filippofinke/reaction-time-training/README.md

# Progetto 3
## Partecipanti:
- Bryan Beffa
- Filippo Finke
- Matteo Ghilardini
---
## Direttive:
Realizzazione di un sistema di gioco e simulazione per l'allenamento dei tempi di reazione ed il miglioramento della coordinazione per sportivi basato su Arduino.

---

## Date:
- Inizio: 13/02/2019
- Fine: 22/05/2019
