filippofinke/reaction-time-training/appunti-schema.md

### Configurazione pin dei bottoni:

| Bottone | Pin |
|:---:|----:|
| 0 |  22 |
| 1 |  24 |
| 2 |  26 |
| 3 |  28 |
| 4 |  30 |
| 5 |  32 |
| 6 |  34 |
| 7 |  36 |
| 8 |  38 |
| 9 |  40 |
| # |  42 |
| @ |  44 |

Buzzer1: 6
Buzzer2: 7

Arduino mega:  20 (SDA), 21 (SCL)
