filippofinke/reaction-time-training/pianifica.md

### Da rivedere:

### Da fare:
5. Tiro a vuoto – pulsanti 1 secondo, senior

Comando per uscire da qualsiasi programma.

### In corso

### Fatti da testare
10. Tabelline, test di velocità
99. Errori e problemi fa gestire

### Testati
1. Cumulativo 60 secondi, senior
2. Maratona (5 minuti) senior
3. Corsa 50 pulsanti, senior
4. Stretching angolare, 100 pulsanti, senior
6. Test di Léger o Beep test, senior
7. 50 pulsanti temporizzati, 1 secondo per pulsante, senior
8. Staffetta 4 giocatori (tempo totale 120 secondi), senior
9. Reazione, somma aritmetica
11. Stretching angolare, 25 pulsanti
12. Stretching angolare, 50 pulsanti
13. 25 pulsanti temporizzati, 1 secondo per pulsante, junior
14. 50 pulsanti temporizzati, 1 secondo per pulsante, junior
15. Cumulativo 30 secondi, junior
16. Cumulativo 60 secondi, junior
17. Corsa 25 pulsanti, junior
18. Corsa 50 pulsanti, junior
19. Maratona (3 minuti) junior
20. Semplice gioco Simon: 20 pulsanti, 17 livelli
21. Flash test, 5 schemi
22. Anti- flash test 
23. Reazione veloce, 10 schemi
