filippofinke/reaction-time-training/Presentations/Presentazione.pptx

Batak 2.0

Bryan Beffa, Filippo Finke & Matteo Ghilardini

Notes: Ghila

## Su di noi.

- Bryan Beffa
bryan.beffa@samtrevano.ch
- Filippo Finke
filippo.finke@samtrevano.ch
- Matteo Ghilardini
matteo.ghilardini@samtrevano.ch

Notes: Ghila

## Introduzione.

- Sistema per misurare e migliorare i propri riflessi

Notes: Ghila

## Slide 4

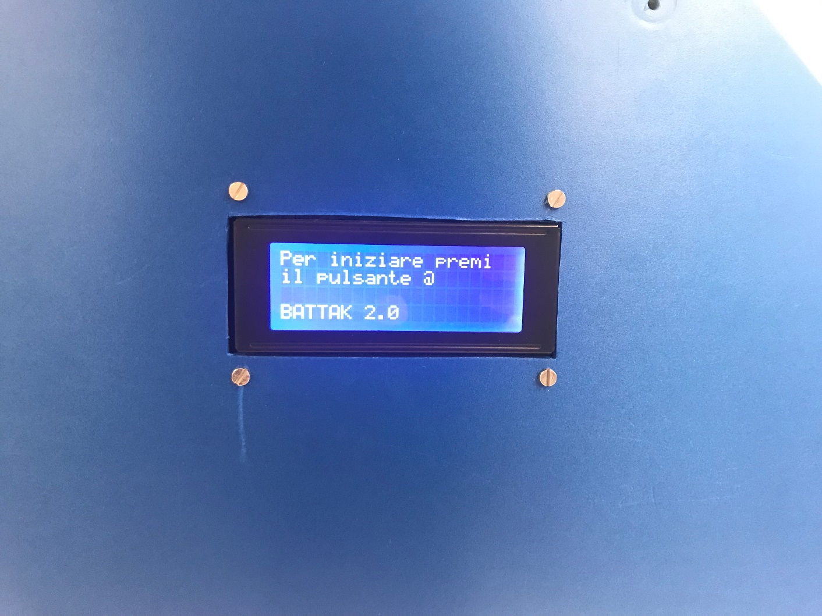
[picture p9: figure]
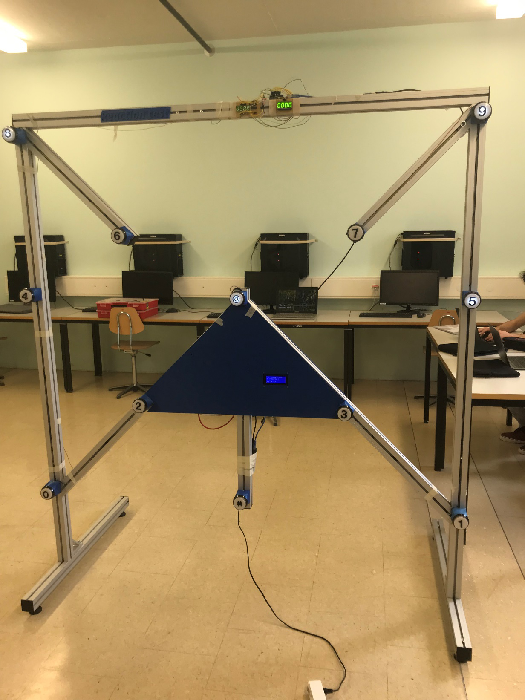
[picture p10: figure]
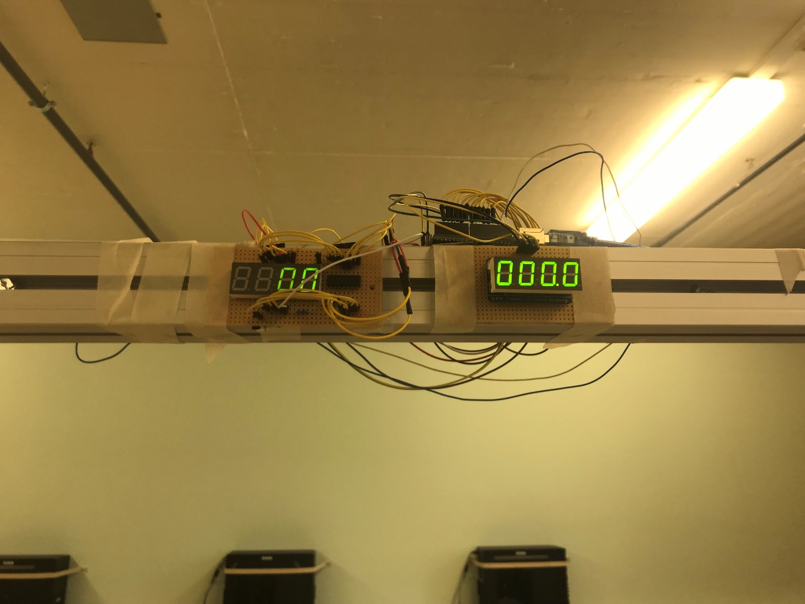
[picture p11: figure]

Notes: Finke

## Scopo.

- Misurare/testare
- Migliorare
- Fare attività fisica

Notes: Bryan:
Misurare: i riflessi di chi prova il nostro sistema
Migliorare i propri riflessi
Aiuta le persone a fare attività fisica. Vedi maratona 5 minuti.

## Requisiti.

Programmi/modalità
Arduino
Procedura di check

Notes: Bryan:
Il nostro sistema doveva/deve avere le varie modalità richieste
Deve essere basato su arduino
Deve avere una procedura di controllo del’hardware

## GANTT preventivo.

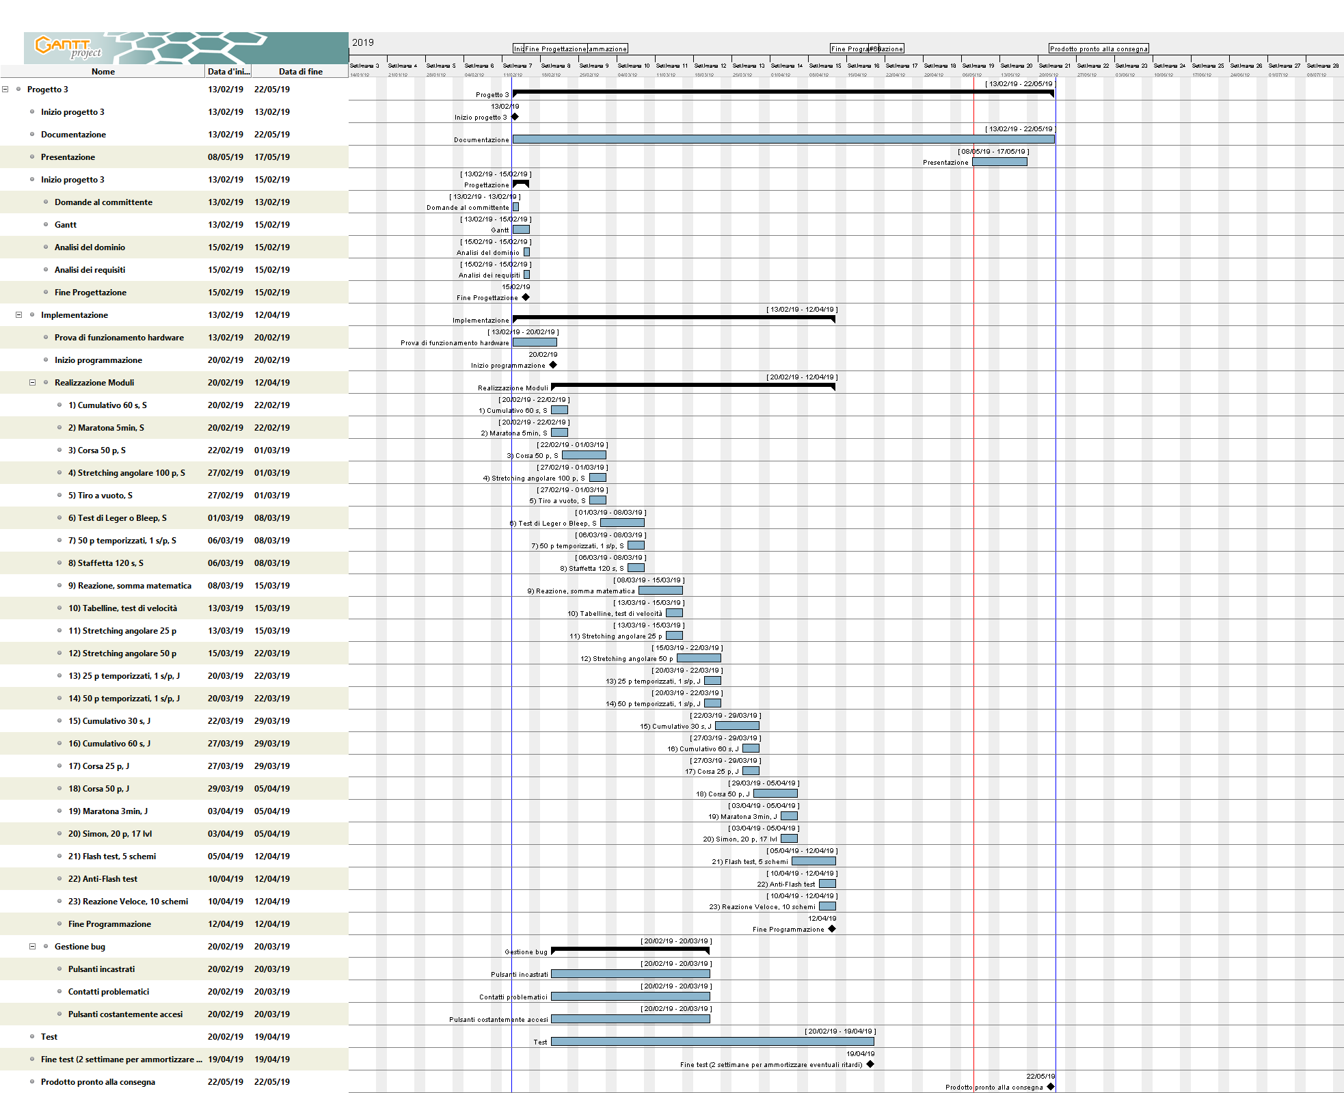
[picture p12: figure]

Notes: Ghila

## Slide 8

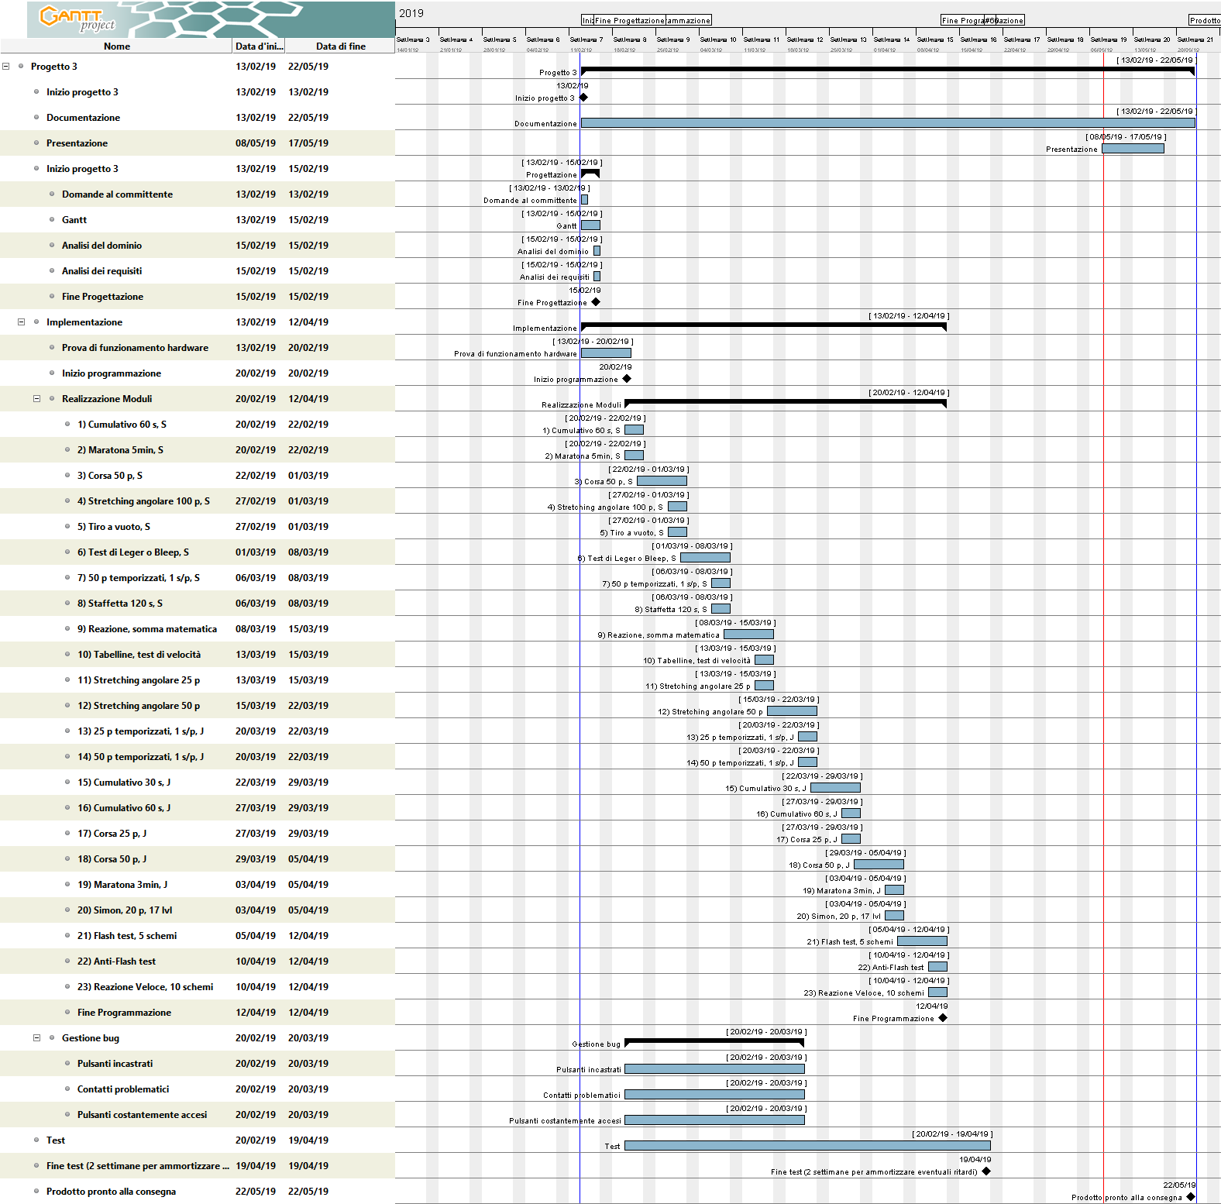
[picture p13: figure]

Notes: Ghila

## Slide 9

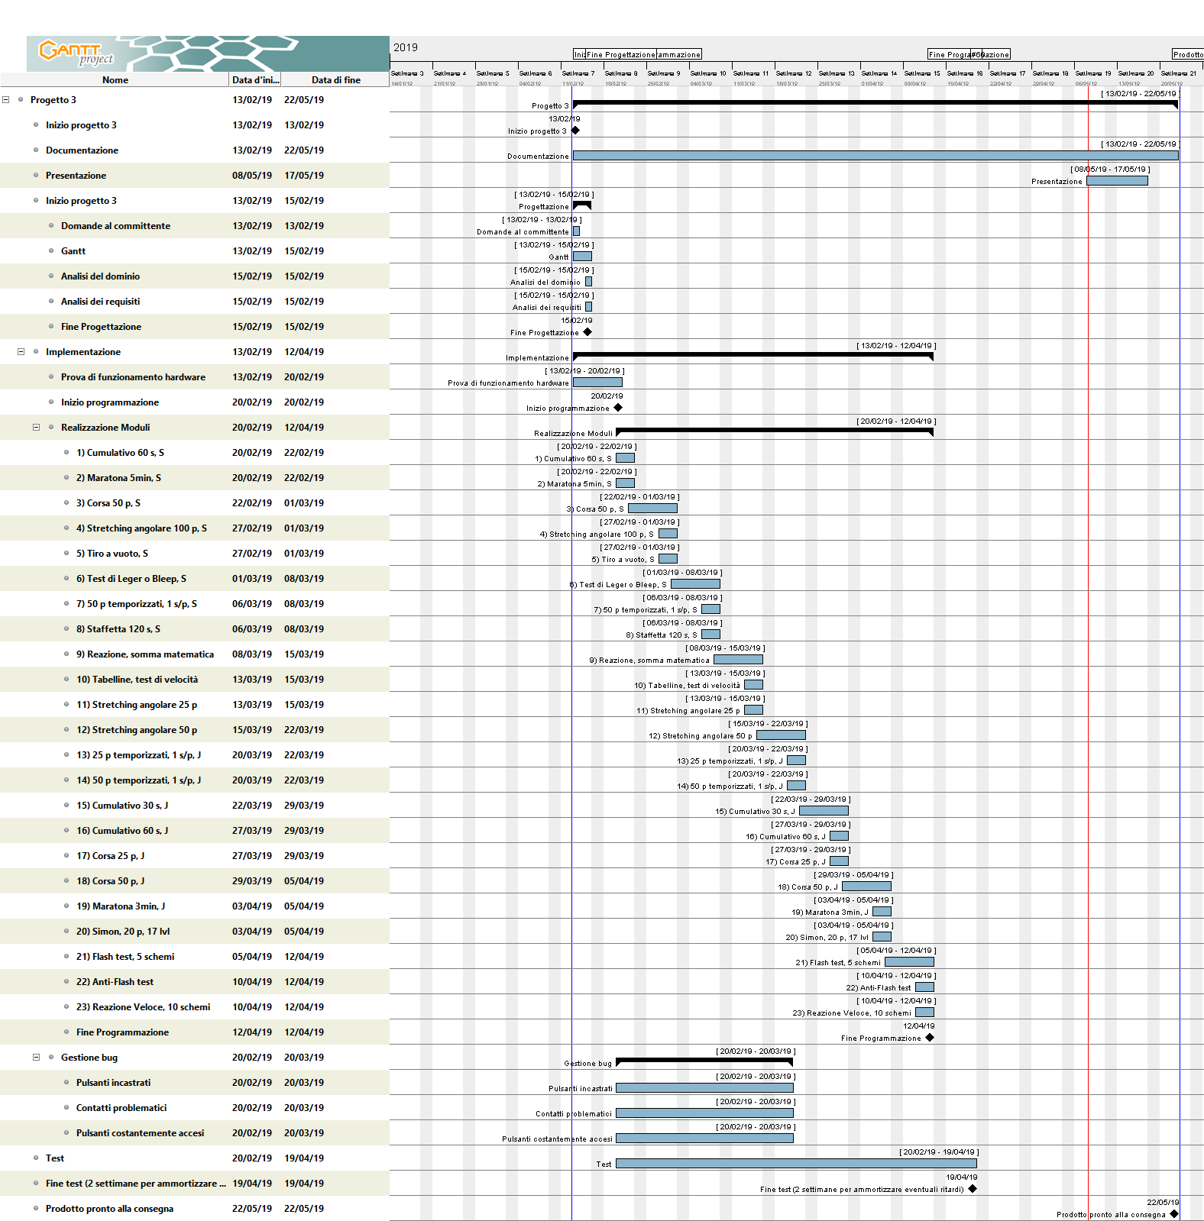
[picture p14: figure]

Notes: Ghila

## GANTT Consuntivo.

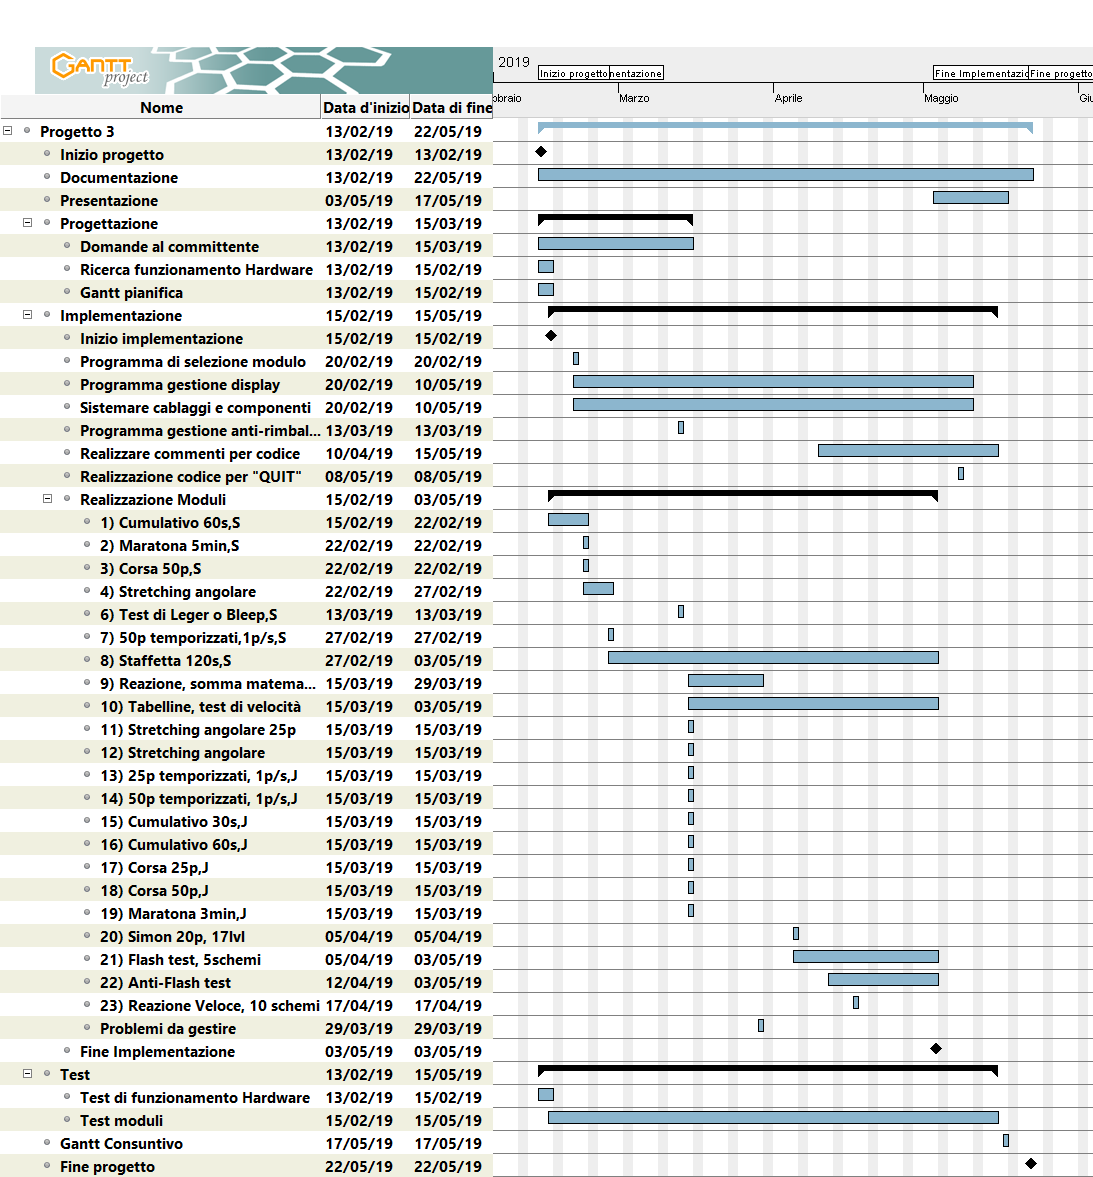
[picture p15: figure]

Notes: Ghila

## Slide 11

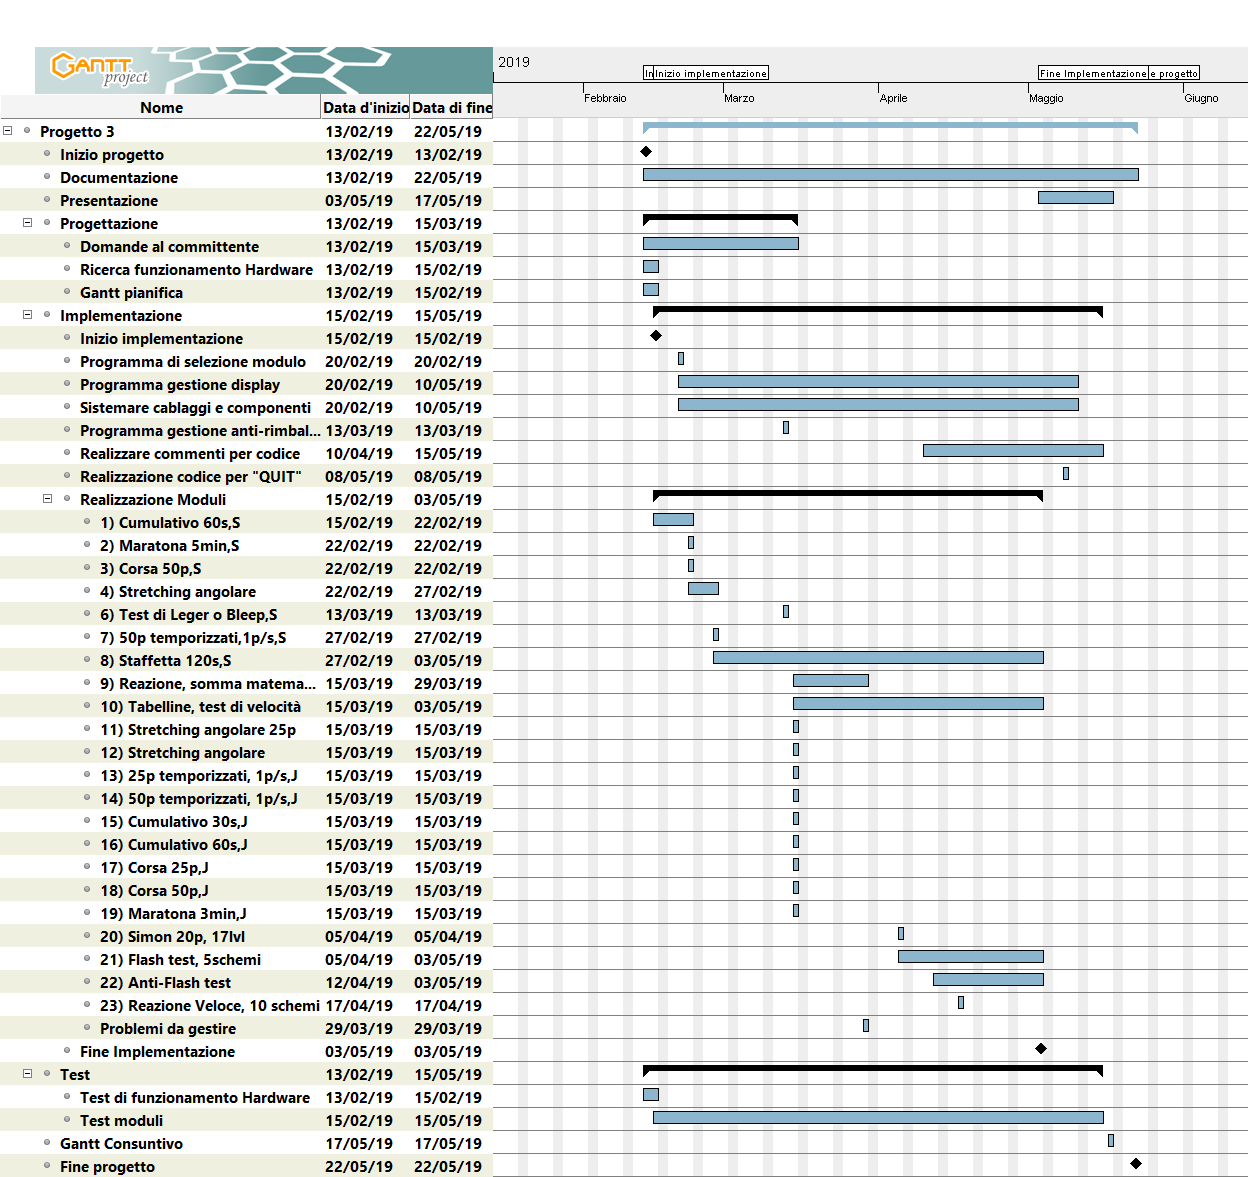
[picture p16: figure]

Notes: Ghila

## Slide 12

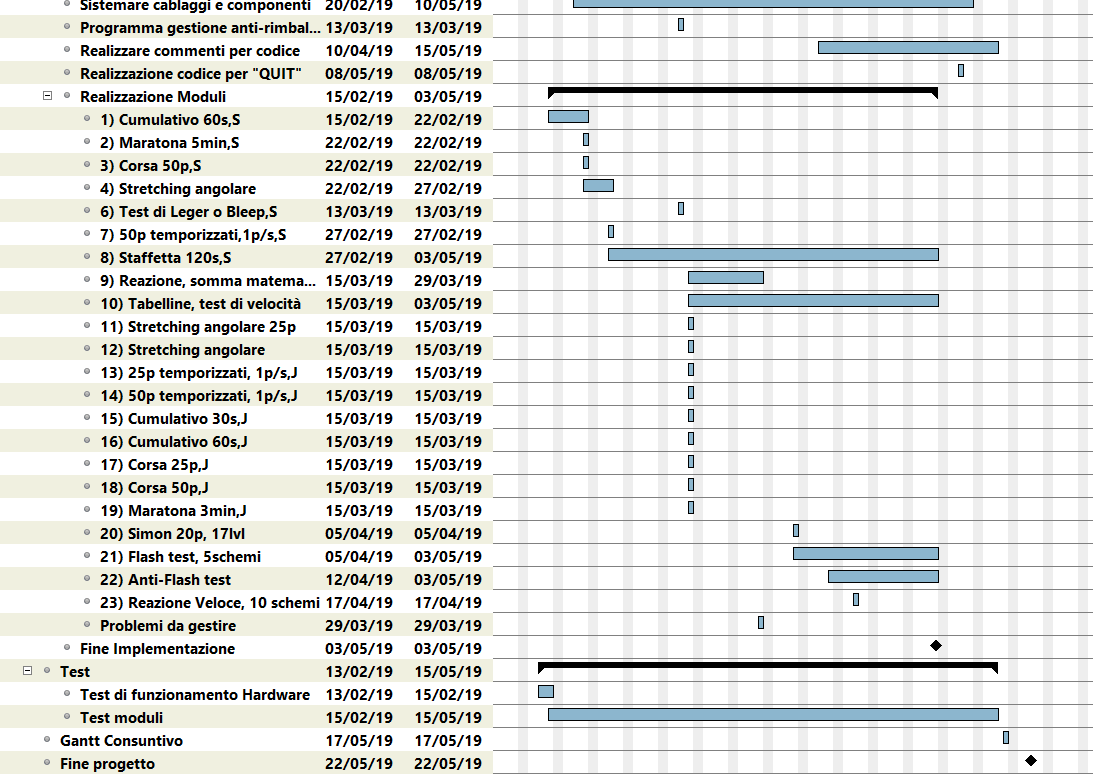
[picture p17: figure]

Notes: Ghila

## Struttura sistema.


Notes: Bryan

## Slide 14

Notes: Bryan:

## Struttura codice.

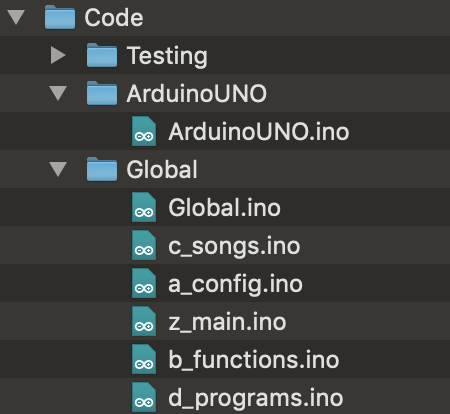
[picture p18: figure]

Notes: finke

## Librerie utilizzate.

- Wire
- LiquidCrystal
- AdaFruit
- SevenSeg

Notes: finke

## File b_functions.

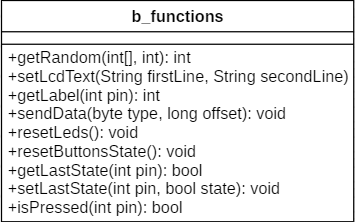
[picture p19: figure]

Notes: finke

## File d_programs.

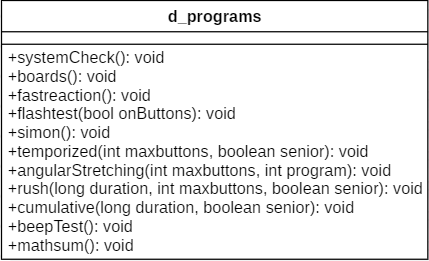
[picture p20: figure]

Notes: finke

## File z_main.

Notes: finke

## Test.

- Test modalità
- Test procedura di check

Notes: Bryan:
Abbiamo effettuato i test su tutti i programmi che sono stati implementati
Abbiamo testato la procedura di controllo del sistema

## Limitazioni.

Programma n° 5
LED
Assistente vocale

Notes: Bryan:
Mancanza del programma numero 5, che richiedeva una pedana/tasto esterno per il funzionamento.
Poca luminosità dei LED
Mancanza assistente vocale nei programmi richiesti

## Sviluppi futuri.

Gestione punteggi
Aggiunta modalità
Hardware

Notes: Bryan:
Gestione punteggi: salvataggio migliori punteggi
Aggiunta di nuove modalità: ad esempio modalità n° 5
Migliorare l’hardware

## Conclusioni.

Notes: Ghila
