filippofinke/reaction-time-training/Documentation/img/b_functions.png

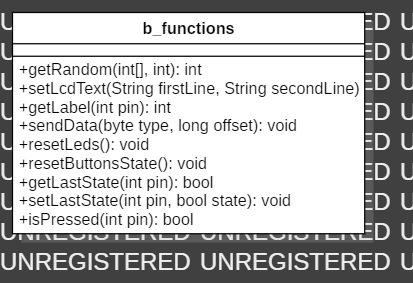
Documentation/img/b_functions.png
