filippofinke/reaction-time-training/Documentation/img/barriera_luminosa.jpg

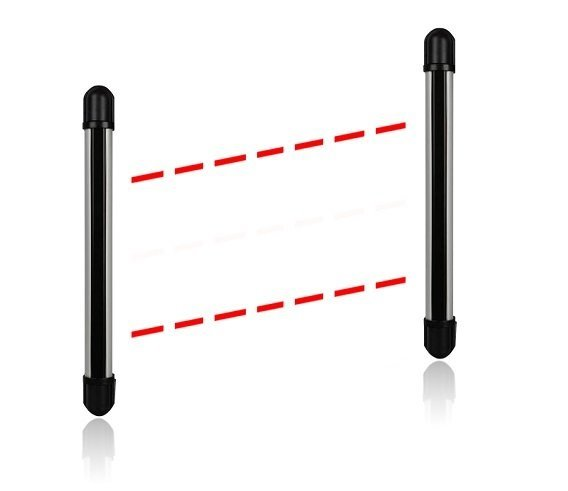
Documentation/img/barriera_luminosa.jpg
