filippofinke/reaction-time-training/Documentation/img/d_programs.png

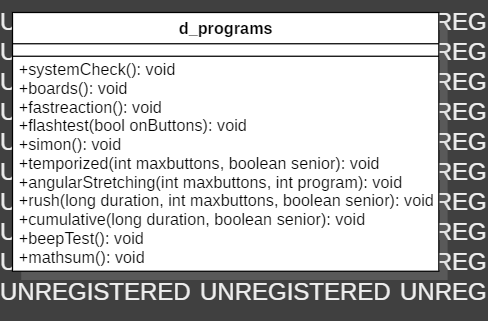
Documentation/img/d_programs.png
