filippofinke/reaction-time-training/Documentation/img/pedana-sollevamento.jpg

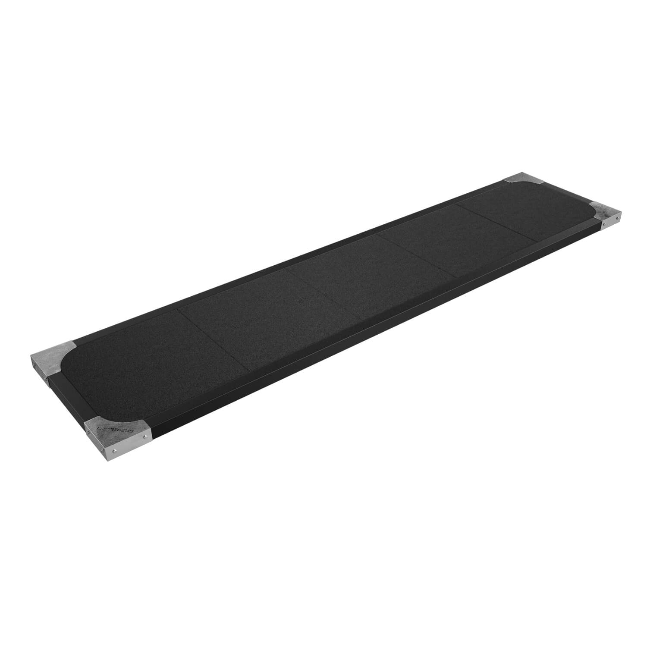
Documentation/img/pedana-sollevamento.jpg
