filippofinke/reaction-time-training/Documentation/img/z_main.png

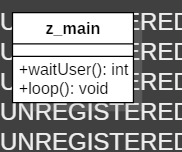
Documentation/img/z_main.png
