filippofinke/reaction-time-training/Gantt Charts/Gantt_Pianificazione.png

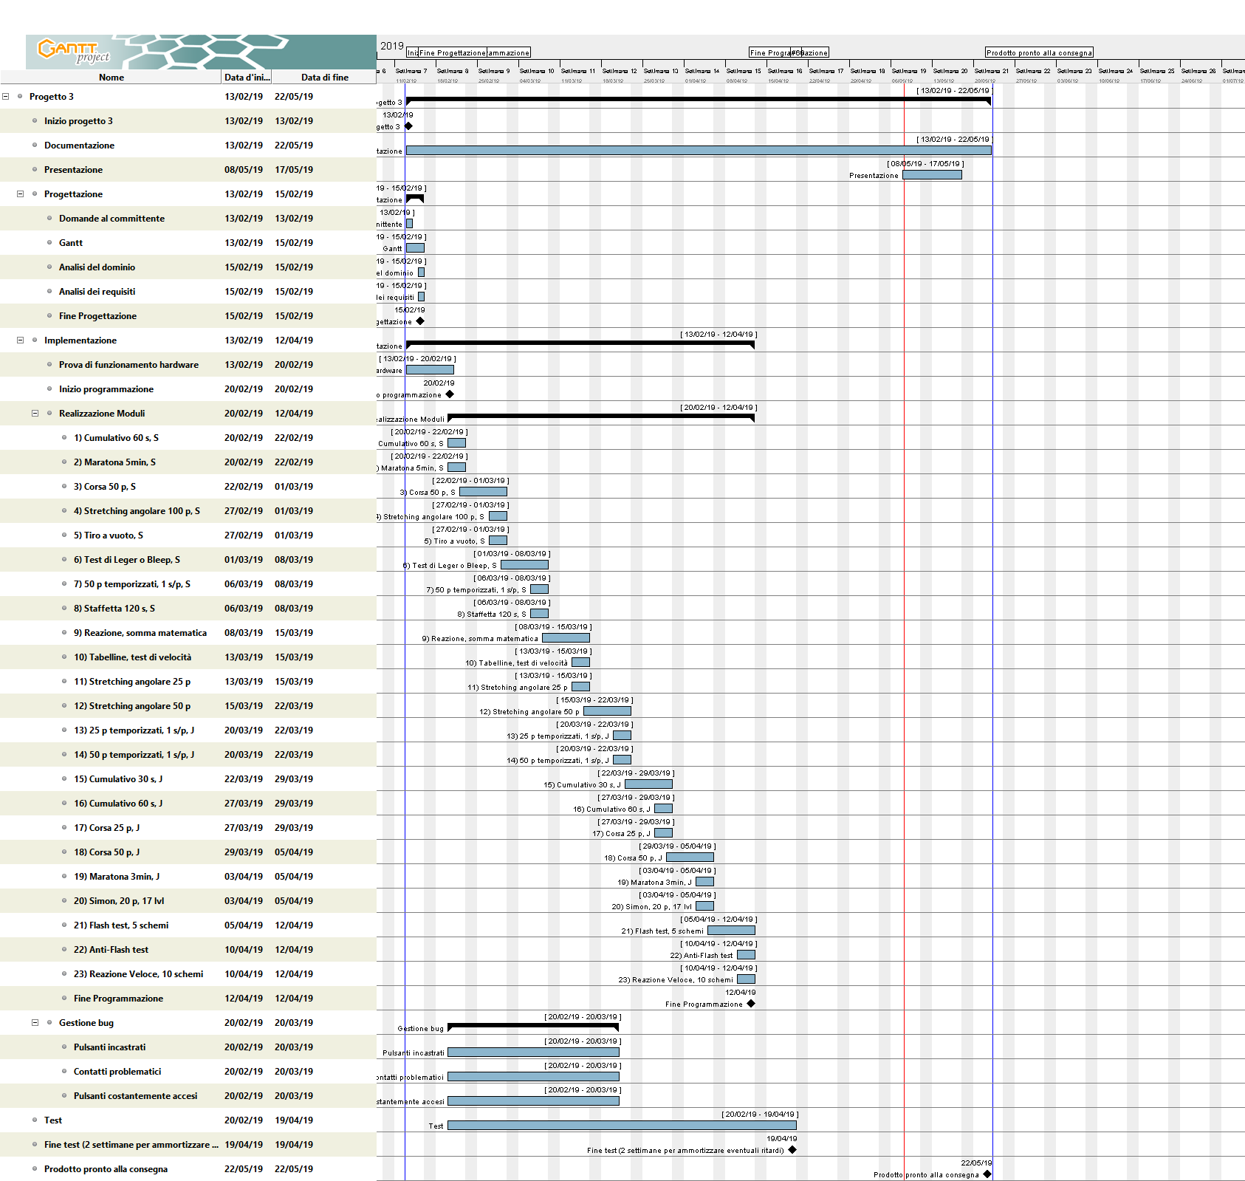
Gantt Charts/Gantt_Pianificazione.png
