filippofinke/reaction-time-training/Documentation/2019.03.22_beffa_finke_ghilardini_procedura_check_manual.docx

# Procedura di check

# Procedura di check

Per controllare che il sistema sia funzionante è stata progettata una procedura di check. È una procedura utilizzata per verificare che il sistema non rilevi errori.

Per avviare la funzione di check bisogna eseguire i seguenti passi:

1. Accendere il sistema e aspettare che sia pronto
2. Premere il pulsante “@”
3. Successivamente selezionare “99”
4. Attendere che il sistema finisca il check del sistema

B. Beffa, F. Finke, M. Ghilardini I3AA 22.03.2019
