filippofinke/reaction-time-training/Work Diaries/md/2019.02.13_i3_beffa_finke_ghilardini_diario_prog3.md

# Progetto 3 | Diario di lavoro
##### B. Beffa, F. FInke, M. Ghilardini
### Trevano, 2019-02-13
---
## Lavori svolti
- Abbiamo ricevuto il QDC;
- Abbiamo realizzato le domande per il committente;
- Iniziato a raccogliere le informazioni per il progetto (documentazione dell’hardware, …);
<br>
Sulla base di questa abbiamo cominciato ad eseguire dei test sul funzionamento del circuito;
    - Testato il funzionamento led e bottoni del telaio;
    - Mappato i pin dei bottoni con il relativo nome;
- Abbiamo realizzato una prima bozza della pianificazione;
- Cominciato la realizzazione della documentazione impostando i requisiti;

---

## Problemi riscontrati e soluzioni adottate 
Nessun problema.

---

##  Punto della situazione rispetto alla pianificazione
(Non ancora svolta definitivamente, ma per quanto riguarda la bozza: In linea)

---

## Programma di massima per la prossima giornata di lavoro
- Aggiunta dei requisiti alla documentazione;
- Completare il capitolo di analisi;
