filippofinke/reaction-time-training/Work Diaries/provvisori/2019.04.12_i3_beffa_finke_ghilardini_diario_prog3.docx

# Diario di lavoro

Luogo | Trevano
Data | 2019-04-12

Lavori svolti

Abbiamo:

- Realizzato il programma 22 (Anti-Flash test);
- Proseguito con la realizzazione della doc realizzando il primo sotto capitolo del capitolo Implementazione;
- Sistemato nuovamente piccoli dettagli nella doc;
- Iniziato l’inserimento dei commenti nel codice;

Problemi riscontrati e soluzioni adottate

Punto della situazione rispetto alla pianificazione

Programmi in corso:

- Stretching angolare, 25 (e 50) pulsanti: dobbiamo sistemare i display 7 segmenti;

Programmi da revisionare:

- Tabelline, test di velocità;
- Tiro a vuoto – pulsanti 1 secondo, senior;

Programmi ancora da fare:

- Reazione veloce, 10 schemi;

Nelle tempistiche ma non rispettando il programma riportato nel Gantt.

Programma di massima per la prossima giornata di lavoro

Proseguire con i programmi mancanti.

Proseguire la stesura del capitolo “Implementazione”.

Sistema di gioco e simulazione per l’allenamento dei tempi di reazione ed il miglioramento della coordinazione per sportivi basato su Arduino.

B. Beffa, F. Finke, M. GhilardiniI3Progetto 3
