filippofinke/reaction-time-training/Work Diaries/provvisori/2019.04.10_i3_beffa_finke_ghilardini_diario_prog3.docx

# Diario di lavoro

Luogo | Trevano
Data | 2019-04-10

Lavori svolti

Abbiamo:

- Realizzato tutti i diari di lavoro quotidiani in formato md;
- Avviato la stesura del capitolo “Implementazione”;
- Aggiunto commenti al codice;
- Revisionato la doc modificando la struttura;

Problemi riscontrati e soluzioni adottate

Punto della situazione rispetto alla pianificazione

Programmi in corso:

- Stretching angolare, 25 (e 50) pulsanti: dobbiamo sistemare i display 7 segmenti;

Programmi da revisionare:

- Tabelline, test di velocità;
- Tiro a vuoto – pulsanti 1 secondo, senior;

Programmi ancora da fare:

- Anti-flash test;
- Reazione veloce, 10 schemi;

Nelle tempistiche ma non rispettando il programma riportato nel Gantt.

Programma di massima per la prossima giornata di lavoro

Proseguire con i programmi mancanti.

Sistema di gioco e simulazione per l’allenamento dei tempi di reazione ed il miglioramento della coordinazione per sportivi basato su Arduino.

B. Beffa, F. Finke, M. GhilardiniI3Progetto 3
