filippofinke/reaction-time-training/Work Diaries/provvisori/2019.04.03_i3_beffa_finke_ghilardini_diario_prog3.docx

# Diario di lavoro

Luogo | Trevano
Data | 2019-04-03

Lavori svolti

Abbiamo deciso di utilizzare la lezione di oggi per eseguire un resoconto del lavoro svolto fino ad oggi. In sostanza abbiamo revisionato ciò che abbiamo scritto fino ad ora nella documentazione ed eseguito i test di ogni programma svolto fino ad oggi.

Problemi riscontrati e soluzioni adottate

Punto della situazione rispetto alla pianificazione

Programmi in corso:

- Stretching angolare, 25 (e 50) pulsanti: dobbiamo sistemare i display 7 segmenti;

Programmi da revisionare:

- Tabelline, test di velocità;
- Tiro a vuoto – pulsanti 1 secondo, senior;

Programmi ancora da fare:

- Semplice gioco Simon: 20 pulsanti, 17 livelli;
- Flash test, 5 schemi;
- Anti-flash test;
- Reazione veloce, 10 schemi;

Globalmente in linea.

Programma di massima per la prossima giornata di lavoro

Proseguire con i programmi mancanti

Sistema di gioco e simulazione per l’allenamento dei tempi di reazione ed il miglioramento della coordinazione per sportivi basato su Arduino.

B. Beffa, F. Finke, M. GhilardiniI3Progetto 3
