filippofinke/reaction-time-training/Work Diaries/provvisori/2019.03.13_i3_beffa_finke_ghilardini_diario_prog3.docx

# Diario di lavoro

Luogo | Trevano
Data | 2019-03-13

Lavori svolti

Abbiamo:

- Preparato il cavo per collegare l’Arduino principale con quello che gestisce i 2 display;
- Risolto il problema relativo all’anti-rimbalzo;
- Rilevati i pin da utilizzare per i Buzzer;
- Implementati programma 6;
- Risolti vari problemi in altri programmi;

Problemi riscontrati e soluzioni adottate

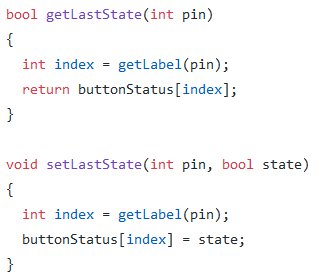
[picture p28: figure]

- Codice che gestisce l’anti-rimbalzo:

Punto della situazione rispetto alla pianificazione

In ritardo (non avevamo preso in considerazione la pausa dovuta alle vacanze scolastiche).

Programma di massima per la prossima giornata di lavoro

Completare programmi fino all’11 e cominciare il 12

Fissare il display 7 segmenti sul telaio

Riflettere sull’implementazione del display LCD

Sistema di gioco e simulazione per l’allenamento dei tempi di reazione ed il miglioramento della coordinazione per sportivi basato su Arduino.

B. Beffa, F. Finke, M. GhilardiniI3Progetto 3
