filippofinke/reaction-time-training/Work Diaries/2019.02.22_i3_beffa_finke_ghilardini_diario_prog3.pdf

B. Beffa, F. Finke, M. Ghilardini | I3 | Progetto 3

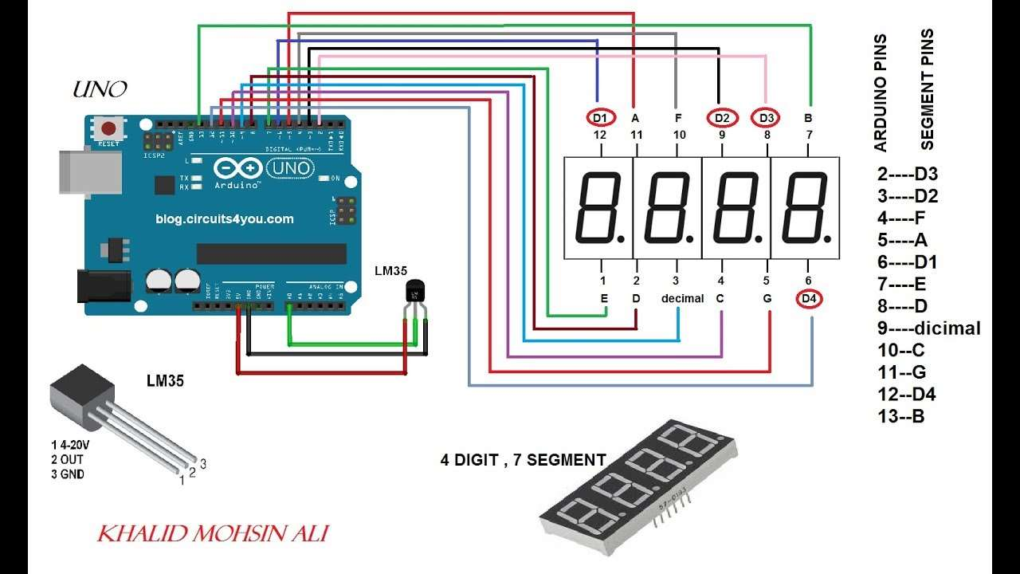
[picture p29: figure]

Sistema di gioco e simulazione per l’allenamento dei tempi di reazione ed il miglioramento della coordinazione per sportivi basato su Arduino.

# Diario di lavoro

Luogo | Trevano
Data | 2019-02-22

Lavori svolti
- Abbiamo:
o Sistemato parzialmente la questione del display 7 segmenti che non funzionava correttamente.
Per fare questo, oltre a ricercare il problema, e agire di conseguenza, abbiamo dovuto dissaldare e poi saldare nuovamente un pin del display;
o I 2 display sono stati collegati fra loro;
o Risolto problema di conversione da stringa ad intero utilizzando la funzione atol() https://forum.arduino.cc/index.php?topic=475803.0;
o Risolto problema parametri di tipo long passando da: cumulative(60 * 1000, false), a cumulative (60000, false);
o Modificato il tipo di ritorno della funzione principale per la seleziona delle modalità di gioco da stringa ad intero;
o Implementato definitivamente programmi 1, 2 e 3;
o Iniziata l’implementazione del programma 4;

Problemi riscontrati e soluzioni adottate
- Il secondo display (quello fissato direttamente su una veroboard e che nella lezione precedente abbiamo dato per rotto e quindi chiesto una sostituzione) non accende tutti i segmenti che dovrebbe, ma rispetto alla lezione precedente, ci siamo resi conto che probabilmente il problema è legato ai cablaggi, per controllare abbiamo utilizzato:

https://i.ytimg.com/vi/utsQWM_FVQg/maxresdefault.jpg ;
o Ci siamo accorti che 1 pin del display non era saldato correttamente, quindi l’abbiamo risaldato;

B. Beffa, F. Finke, M. Ghilardini | I3 | Progetto 3

Sistema di gioco e simulazione per l’allenamento dei tempi di reazione ed il miglioramento della coordinazione per sportivi basato su Arduino.

o Per semplificare la stesura del codice abbiamo deciso di utilizzare una libreria (https://github.com/sparkfun/SevSeg) .
o Altri link che abbiamo utilizzato per raggiungere la soluzione:
- https://create.arduino.cc/projecthub/essoselectronic/sevseg-library-on-4-digitanode-segment-ae7eed;
- https://www.hackster.io/SAnwandter1/programming-4-digit-7-segment-leddisplay-2d33f8;
- https://www.electronics-tutorials.ws/blog/7-segment-display-tutorial.html; o Alcuni valori del display vengono ancora rappresentati in maniera errata;

Punto della situazione rispetto alla pianificazione In anticipo

Programma di massima per la prossima giornata di lavoro Risolvere problema del display.
Proseguire l’implementazione del programma 4 Iniziare implementazione programma 5
