filippofinke/reaction-time-training/Work Diaries/md/2019.02.27_i3_beffa_finke_ghilardini_diario_prog3.md

# Progetto 3 | Diario di lavoro
##### B. Beffa, F. FInke, M. Ghilardini
### Trevano, 2019-02-27
---
## Lavori svolti
- Ci è stato consegnato il display 7 segmenti che avevamo chiesto qualche settimana fa;
- Abbiamo:
    - Implementato i programmi 4, 7 e 8 (5 e 6 posticipati a causa della necessità del cicalino);
    - Realizzato i primi 8 test case;

---

## Problemi riscontrati e soluzioni adottate 
| Problema | Soluzione adottata | 
|---|---|
|Display 7 segmenti non funzionante. | Lo abbiamo sostituito e testato, rimane solo da montarlo sul telaio.|
| Non abbiamo implementato nessun sistema anti-rimbalzo per i pulsanti. | Dovremo pensare a implementarlo al più presto.

---

##  Punto della situazione rispetto alla pianificazione
In anticipo

---

## Programma di massima per la prossima giornata di lavoro
- Completare programmi 5 e 6;
- Installare il display 7 segmenti sul telaio;
