filippofinke/reaction-time-training/Work Diaries/md/2019.03.01_i3_beffa_finke_ghilardini_diario_prog3.md

# Progetto 3 | Diario di lavoro
##### B. Beffa, F. FInke, M. Ghilardini
### Trevano, 2019-03-01
---
## Lavori svolti
Dal momento che entrambi i miei compagni di gruppo (Beffa e Finke), oggi erano asenti, ho approfittato di queste ore per effettuare una revisione generale del lavoro svolto nel corso delle lezioni svolte e sistemare:
- Capitolo 1.6 della documentazione realizzando una versione più compatta e indicativa del Gantt per poterlo rendere più grande e quindi più leggibile;
- Sempre in merito al capitolo 1.6, ho anche realizzato il commento relativo al suddetto Gantt;
- Aggiunto altri requisiti;

---

## Problemi riscontrati e soluzioni adottate 
| Problema | Soluzione adottata | 
|---|---|
| Non abbiamo implementato nessun sistema anti-rimbalzo per i pulsanti. | Dovremo pensare a implementarlo al più presto.

---

##  Punto della situazione rispetto alla pianificazione
In anticipo di circa 1 settimana

---

## Programma di massima per la prossima giornata di lavoro
- Completare programmi 5 e 6;
- Installare il display 7 segmenti;
