filippofinke/reaction-time-training/Work Diaries/md/2019.03.15_i3_beffa_finke_ghilardini_diario_prog3.md

# Progetto 3 | Diario di lavoro
##### B. Beffa, F. FInke, M. Ghilardini
### Trevano, 2019-03-15
---
## Lavori svolti
Oggi abbiamo:
- Aggiunto i programmi dal 9 al 19;
- Revisionato alcuni dei programmi realizzati in precedenza per aggiungere dinamicità nella stesura del codice;
- Discusso dei programmi “Tabelline, test di velocità” e “Tiro a vuoto – pulsanti 1 secondo, senior”, il problema consiste nel fatto di dover fare un suono audio e non di frequenza e che di conseguenza con il buzzer non possiamo farlo. Ci è stato detto di lasciarli da parte per il momento;
- Proseguito i protocolli di test dal 12 al 20;
- Completato la stesura dei requisiti (realizzati 20, 21, 22, 23, 24);
- Revisionato e corretto la doc;

---

## Problemi riscontrati e soluzioni adottate 
| Problema | Soluzione adottata | 
|---|---|
|Con il buzzer possiamo solo esprimere delle frequenze e non del testo.|Su direttiva del committente, lasciamo perdere per il momento. 

---

##  Punto della situazione rispetto alla pianificazione
Recuperato il ritardo della lezione scorsa arrivando ad essere in anticipo sulla pianificazione.

---

## Programma di massima per la prossima giornata di lavoro
- <b>Test di Léger o Beep test, senior</b><br>
Mancanza: Implementare il display LCD.
- <b>Reazione, somma aritmetica</b><br>
Mancanza: Display LCD.
- <b>Stretching angolare, 25 pulsanti</b><br>
Mancanza: Fix display 7 segmenti (la virgola).
- <b>Stretching angolare, 50 pulsanti</b><br>
Mancanza: Fix display 7 segmenti (la virgola).
