filippofinke/reaction-time-training/Work Diaries/md/2019.04.05_i3_beffa_finke_ghilardini_diario_prog3.md

# Progetto 3 | Diario di lavoro
##### B. Beffa, F. FInke, M. Ghilardini
### Trevano, 2019-04-05
---
## Lavori svolti
Abbiamo completato i programmi:
- Semplice gioco di Simon: 20 pulsanti, 17 livelli;
- Flash test, 5 schemi;

---

## Problemi riscontrati e soluzioni adottate 
| Problema | Soluzione adottata | 
|---|---|
|

---

##  Punto della situazione rispetto alla pianificazione

Globalmente in linea.

- Programmi in corso:
    - <b>Stretching angolare, 25 (e 50) pulsanti: </b><br>dobbiamo sistemare i display 7 segmenti;
- Programmi da revisionare:
    - Tabelline, test di velocità;
    - Tiro a vuoto - pulsanti 1 secondo, senior;
- Programmi ancora da fare:
    - Anti-flash test;
    - Reazione veloce, 10 schemi;

---

## Programma di massima per la prossima giornata di lavoro
- Proseguire con i programmi mancanti.
