filippofinke/reaction-time-training/Work Diaries/md/2019.02.15_i3_beffa_finke_ghilardini_diario_prog3.md

# Progetto 3 | Diario di lavoro
##### B. Beffa, F. FInke, M. Ghilardini
### Trevano, 2019-02-15
---
## Lavori svolti
- Finke ha dovuto svolgere la presentazione del Progetto 2;
- Abbiamo:
    - Completato il diagramma Gantt;
    - Proseguito nella parte di analisi dei requisiti;
    - Completato l'analisi del dominio;
    - Completato il capitolo "Scopo";
    - Realizzato un codice per testare il funzionamento del display 7 segmenti
    - Iniziato a realizzare il codice per il primo modulo;

---

## Problemi riscontrati e soluzioni adottate 
| Problema | Soluzione adottata | 
|---|---|
|Il 7 segmenti che dovrebbe indicare il tempo, non funziona. | Ci siamo accorti che il problema era nei contatti del display, quindi la soluzione che abbiamo adottato è stata quella di raddrizzarli e inserirli in modo corretto nei vari pin. |
| La luminosità dei vari pulsanti era troppo bassa. | Avevamo dimenticato di impostare il pimode().

---

##  Punto della situazione rispetto alla pianificazione
Leggermente in anticipo.

---

## Programma di massima per la prossima giornata di lavoro
- Completare la fase per il check del funzionamento dell’hardware;
- Proseguire il modulo 1 (Cumulativo 60 [s], Senior) e iniziare il successivo;
