filippofinke/reaction-time-training/Work Diaries/provvisori/2019.05.22_i3_beffa_finke_ghilardini_diario_prog3.docx

# Diario di lavoro

Luogo | Trevano
Data | 2019-05-22

Lavori svolti

Oggi abbiamo:

- Completato la documentazione;
- Sistemato il pulsante “#” che si incastrava molto spesso;
- Fissato al telaio il pulsante “1” che dall’inizio del progetto era fissato solo con del nastro adesivo;
- Unito i diari per la stampa;
- Stampato sia i diari, sia la documentazione;
- Rilegato il fascicolo;
- Consegnato il progetto;

Problemi riscontrati e soluzioni adottate

Punto della situazione rispetto alla pianificazione

Progetto completato entro la data designata

Programma di massima per la prossima giornata di lavoro

Sistema di gioco e simulazione per l’allenamento dei tempi di reazione ed il miglioramento della coordinazione per sportivi basato su Arduino.

B. Beffa, F. Finke, M. GhilardiniI3Progetto 3
