filippofinke/reaction-time-training/Work Diaries/provvisori/2019.05.17_i3_beffa_finke_ghilardini_diario_prog3.docx

# Diario di lavoro

Luogo | Trevano
Data | 2019-05-17

Lavori svolti

Oggi abbiamo:

- Realizzato il Gantt consuntivo;
- Completato i sotto-capitoli dell’implementazione 20 e 22;
- Terminato la presentazione;
- Aggiunto il consuntivo alla doc (manca il commento);
- Sistemato il layout della maggior parte dei codici del capitolo implementazione;
- Aggiunta la sitografia alla doc;

Problemi riscontrati e soluzioni adottate

Punto della situazione rispetto alla pianificazione

Nelle tempistiche

Programma di massima per la prossima giornata di lavoro

Completare il capitolo 21 e il 23 dell’implementazione

Revisione globale del lavoro prima di consegnarlo

Sistema di gioco e simulazione per l’allenamento dei tempi di reazione ed il miglioramento della coordinazione per sportivi basato su Arduino.

B. Beffa, F. Finke, M. GhilardiniI3Progetto 3
