filippofinke/reaction-time-training/Work Diaries/provvisori/2019.05.15_i3_beffa_finke_ghilardini_diario_prog3.docx

# Diario di lavoro

Luogo | Trevano
Data | 2019-05-15

Lavori svolti

Oggi abbiamo proseguito il capitolo “Implementazione” (i sotto-capitoli fino al 20 e il 22 e il 24 sono completati) e realizzato nuovi commenti per il codice sistemando anche nuovi piccoli errori sorti dall’analisi più approfondita del codice.

Problemi riscontrati e soluzioni adottate

Punto della situazione rispetto alla pianificazione

Non escludiamo la possibilità di terminare il lavoro in anticipo di qualche ora.

Programma di massima per la prossima giornata di lavoro

Terminare la stesura del capitolo “Implementazione” e realizzare il gantt consuntivo in modo da inserirlo e completare così la presentazione.

Sistema di gioco e simulazione per l’allenamento dei tempi di reazione ed il miglioramento della coordinazione per sportivi basato su Arduino.

B. Beffa, F. Finke, M. GhilardiniI3Progetto 3
