filippofinke/reaction-time-training/Work Diaries/provvisori/2019.04.17_i3_beffa_finke_ghilardini_diario_prog3.docx

# Diario di lavoro

Luogo | Trevano
Data | 2019-04-17

Lavori svolti

Abbiamo:

- Riempito la tabella dei test nella documentazione, notando che alcuni programmi presentavano qualche imperfezione da sistemare;
- Implementato il programma 23 e sistemati altri;
- Proseguito il capitolo “Implementazione” della doc;
- Proseguito l’inserimento dei commenti nel codice;
- Inserito il requisito 5 nella doc perché lo avevamo lasciato indietro a causa dell’impossibile realizzazione di esso;

Per realizzare il programma 10, ci serve un amplificatore per poter “dire” le tabelline che poi il giocatore dovrà risolvere. Dobbiamo procurarcene uno il prima possibile. Abbiamo trovato questo:

https://www.sparkfun.com/products/12660

Problemi riscontrati e soluzioni adottate

Punto della situazione rispetto alla pianificazione

Nelle tempistiche ma non rispettando il programma riportato nel Gantt.

Programma di massima per la prossima giornata di lavoro

Sistemare i programmi mancanti.

Proseguire la stesura del capitolo “Implementazione”.

Sistema di gioco e simulazione per l’allenamento dei tempi di reazione ed il miglioramento della coordinazione per sportivi basato su Arduino.

B. Beffa, F. Finke, M. GhilardiniI3Progetto 3
