filippofinke/reaction-time-training/Work Diaries/provvisori/2019.02.27_i3_beffa_finke_ghilardini_diario_prog3.docx

# Diario di lavoro

Luogo | Trevano
Data | 2019-02-27

Lavori svolti

- Ci è stato consegnato il display 7 segmenti che avevamo chiesto qualche settimana fa
- Abbiamo:
  - Implementati programmi 4, 7 e 8 (5 e 6 posticipati a causa della necessità del cicalino);
  - Realizzato i primi 8 test case;

Problemi riscontrati e soluzioni adottate

- Avendo ricevuto il nuovo 7 segmenti, abbiamo risolto tutti i problemi legati ad esso, ci rimane solo da installarlo sul telaio.
- Non c’è l’anti-rimbalzo sui pulsanti, dovremo implementarlo al più presto.

Punto della situazione rispetto alla pianificazione

In anticipo

Programma di massima per la prossima giornata di lavoro

Completare programmi 5 e 6

Installare il display 7 segmenti sul telaio

Sistema di gioco e simulazione per l’allenamento dei tempi di reazione ed il miglioramento della coordinazione per sportivi basato su Arduino.

B. Beffa, F. Finke, M. GhilardiniI3Progetto 3
