filippofinke/reaction-time-training/Work Diaries/provvisori/2019.02.15_i3_beffa_finke_ghilardini_diario_prog3.docx

# Diario di lavoro

Luogo | Trevano
Data | 2019-02-15

Lavori svolti

- Finke ha dovuto svolgere la presentazione del progetto 2;
- Abbiamo:
  - Completato il diagramma Gantt;
  - Proseguito con la parte di analisi dei requisiti;
  - Completato l’analisi del dominio;
  - Completato lo scopo;
  - Realizzato un codice per verificare il funzionamento del display sette-segmenti;
  - Iniziato a realizzare il codice per il primo modulo;

Problemi riscontrati e soluzioni adottate

- Il sette-segmenti che dovrebbe indicare il tempo non funzionava;
  - Ci siamo accorti che il problema era nei contatti del display, quindi la soluzione che abbiamo adottato è stata quella di raddrizzarli e inserirli in modo corretto nei vari pin.
- La luminosità dei vari pulsanti era troppo bassa;
  - Avevamo dimenticato di impostare il pinmode;

Punto della situazione rispetto alla pianificazione

Leggermente in anticipo

Programma di massima per la prossima giornata di lavoro

Completare la fase per il check del funzionamento dell’hardware

Proseguire il modulo 1 (Cumulativo 60 [s], Senior) e iniziare il successivo

Sistema di gioco e simulazione per l’allenamento dei tempi di reazione ed il miglioramento della coordinazione per sportivi basato su Arduino.

B. Beffa, F. Finke, M. GhilardiniI3Progetto 3
