filippofinke/reaction-time-training/Code/Global/Global.ino

/*
   Gloabl
   File il quale da il nome al progetto Arduino da parte dell'IDE.

   @author Filippo Finke

      LABEL    PIN

   |    0    |  22 |
   |    1    |  24 |
   |    2    |  26 |
   |    3    |  28 |
   |    4    |  30 |
   |    5    |  32 |
   |    6    |  34 |
   |    7    |  36 |
   |    8    |  38 |
   |    9    |  40 |
   |    #    |  42 |
   |    @    |  44 |
*/
