filippofinke/reaction-time-training/(commit log)

2019-02-13 Added buttonsDoc.md
2019-02-20 Added ArduinoUNO.ino
2019-02-22 Fix code style and added a third game mode
    [c_cumulative.ino]
2019-02-22 Fixed junior to senior
    [z_main.ino]
2019-02-27 Fixed headers and renamed c_cumulative.ino to c_programs.ino
    [Global.ino, a_config.ino, b_functions.ino]
2019-03-13 Added array to manage last button states
2019-03-13 Added functions to manage button state bouce
2019-03-13 Fixed button bounce
2019-03-13 added future para
2019-03-15 Updated current status
2019-03-15 Updated with current status
2019-03-15 Fixed pinMode in setup
    [a_config.ino]
2019-03-22 Added LCD support to Test di Léger o Beep test
2019-03-27 Generalized print text
2019-04-17 Added fastreaction program and fixed flashtest
    [d_programs.ino, z_main.ino]
2019-04-17 completed test case RQ-5
2019-04-17 added test case RQ-06
2019-05-08 completed test case table
2019-05-15 Fixed boards
2019-05-20 update doc and fix code numeration
    [d_programs.ino]
